M5Ross/AccDec_SoundLevelCrossing/pcb/BOM_PCB_AccDecPLSound.csv

ID | Name | Designator | Footprint | Quantity | Manufacturer Part | Manufacturer | Supplier | Supplier Part | Price
1 | 100nF(104) | C4,C8 | CAP-CT4G-0805-2.54MM | 2 | CT4-0805Y104M500F1 | FH | LCSC | C154503 | 0.034
2 | 10uF | C1,C7 | CAP-D5.0XF2.0 | 2 | 10uF 50V 5*11 | ValuePro | LCSC | C43345 | 0.013
3 | 22pF | C2,C3 | CAP-TH_L3.5-W3.0-P2.54-D0.8 | 2 | 22pf/50V 10% | ReliaPro | LCSC | C9316
4 | 1000uF | C6 | CAP-D12.5XF5.0 | 1 | 1000uF 35V 13*20Purple high frequency | ValuePro | LCSC | C45083 | 0.113
5 | 1N4148 | D4 | DO-35 | 1 | 1N4148 | SEMTECH | LCSC | C14516 | 0.008
6 | 2W10 | D5 | BRIDGE-WOB | 1 | 2W10 | MDD | LCSC | C3064 | 0.103
7 | DFPLAYER-MINI-MODULE | G$1 | DFPLAYER-MINI-MODULE | 1
8 | HDR-F-2.54_1x3 | H1,H2,H3,H4,H5,H6,H7,H8,H9,H10,H11,H12 | HDR-F-2.54_1X3 | 12 |  |  | LCSC | C146690 | 0.08
9 | 15*10.5*21 | HEAT1 | 15*10.5*21 | 1 | - | Made in China | LCSC | C4649 | 0.078
10 | LED-3MM | LED1 | LED-3MM/2.54 | 1 | 204-10SURD/S530-A3 | EVERLIGHT | LCSC | C99772 | 0.029
11 | WJ126V-5.0-2P | P1,P2,P3,P4,P5 | WJ126V-5.0-2P | 5 | WJ126V-5.0-2P | ReliaPro | LCSC | C8404 | 0.068
12 | WJ126V-5.0-3P | P9 | WJ126V-5.0-3P | 1 | WJ126V-5.0-3P | ReliaPro | LCSC | C8401 | 0.105
13 | Header-Female-2.54_1x4 | P10 | HDR-4X1/2.54 | 1 | Header-Female-2.54_1x4 | ReliaPro | LCSC | C124413 | 0.114
14 | 1k | R1,R2,R4,R6,R7,R8,R9,R10,R11,R12 | AXIAL-0.3 | 10 | ?
15 | 10k | R3,R5 | AXIAL-0.3 | 2 | ?
16 | 7805 | U3 | TO-220-3_L10.0-W4.5-P2.54-L | 1 | 7805 | Foshan Blue Rocket Elec | LCSC | C305416 | 0.158
17 | 6N136 | U4 | DIP-8 | 1 | 6N136 | Isocom Components | LCSC | C94861 | 0.492
18 | ATMEGA328P-PU | U5 | DIP-28_300MIL | 1 | ATMEGA328P-PU | MICROCHIP | LCSC | C33901 | 3.273
19 | 16MHz | X1 | HC-49S | 1 | E49A16E00000KE10CO | HOSONIC | LCSC | C114981
