M5Ross/AccDec_SoundLevelCrossing/sch/Schematic_AccDecPLSound.pdf

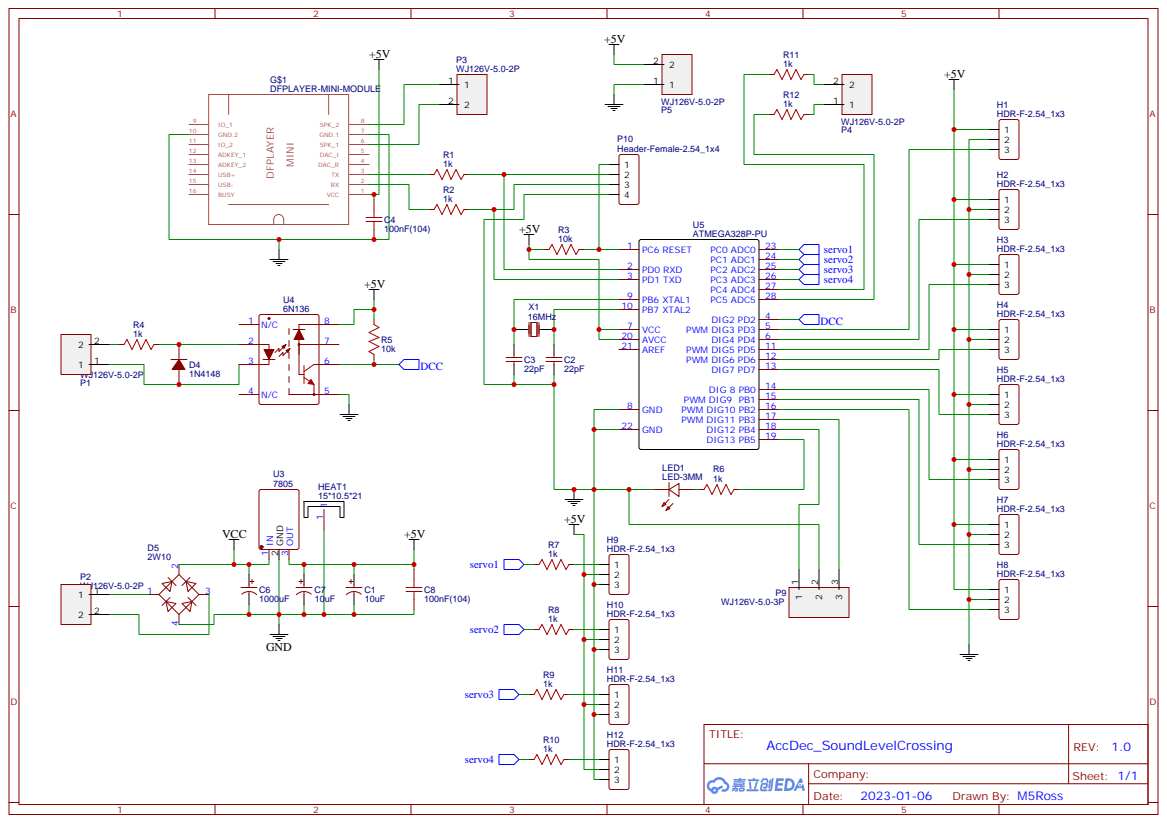
[picture p1: page 1]
